buho29/wormgear/demo/README.en.md

<div align="center">

# ⚙️ WormGear demo

### A worm and its wheel to print, assemble and turn by hand

[Español](README.md) · **English** · [WormGear](../README.en.md)

Assembled demo

</div>

Printable demo of WormGear's default gear set: module 1.5, 30-tooth wheel, single-start Ø16 worm with a 35 mm thread, and 45° flanks. Turn the knob and the wheel makes one turn for every 30 turns of the worm. The gear set is generated by [WormGear](../README.en.md).

The worm and the wheel are each printed **in one piece with their shafts**, which turn in "bearings" made of two 45° cones. The caps slide down into the columns, guided by tongues.

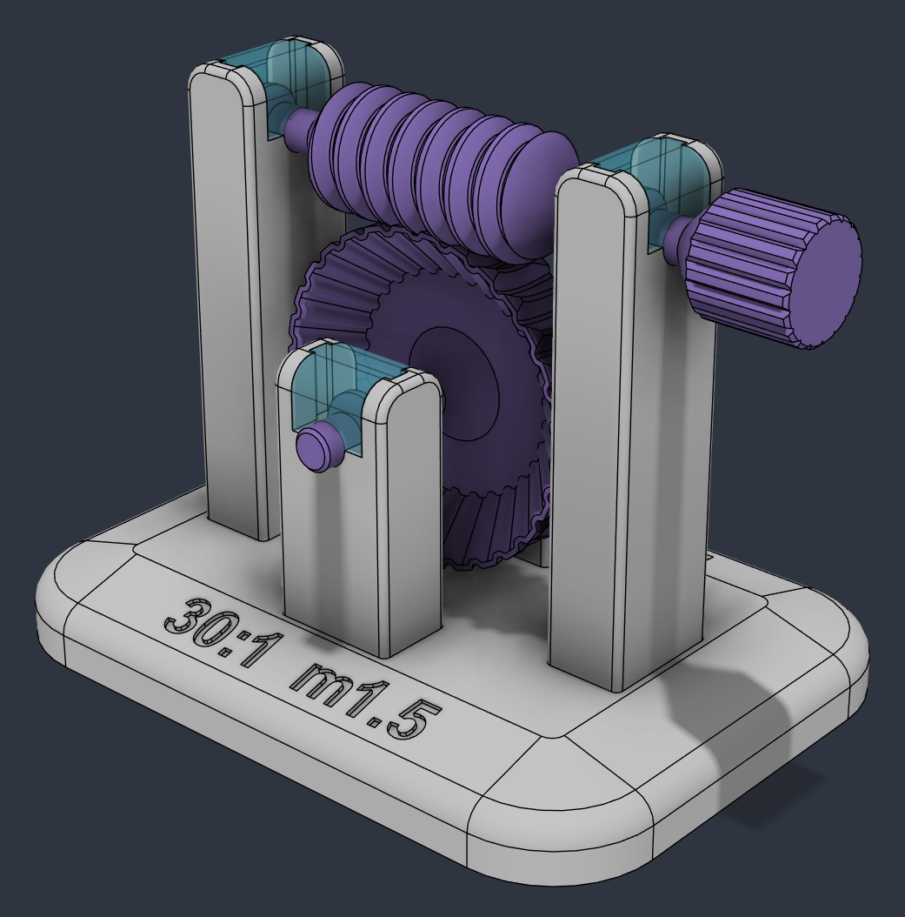
[picture p18: demo/img/conjunto_atras.png]
Rear view


## 📷 Printed

| | | |
|---|---|---|
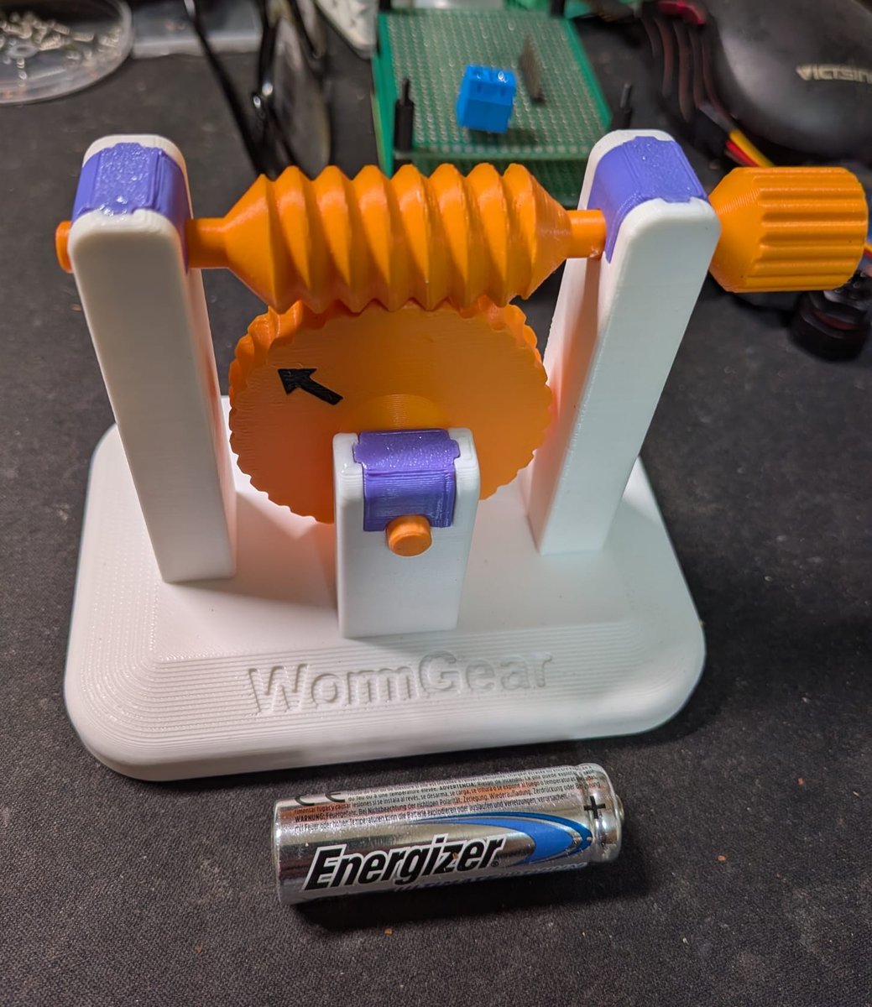
[picture p19: demo/img/impresa_frente.jpg]
Printed demo, front
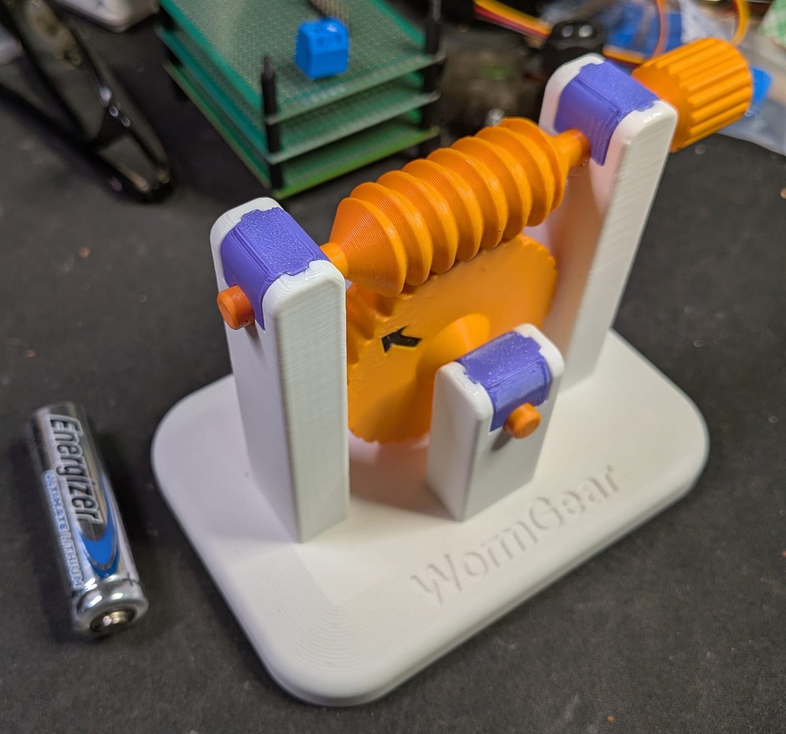
[picture p20: demo/img/impresa_lado.jpg]
Printed demo, side
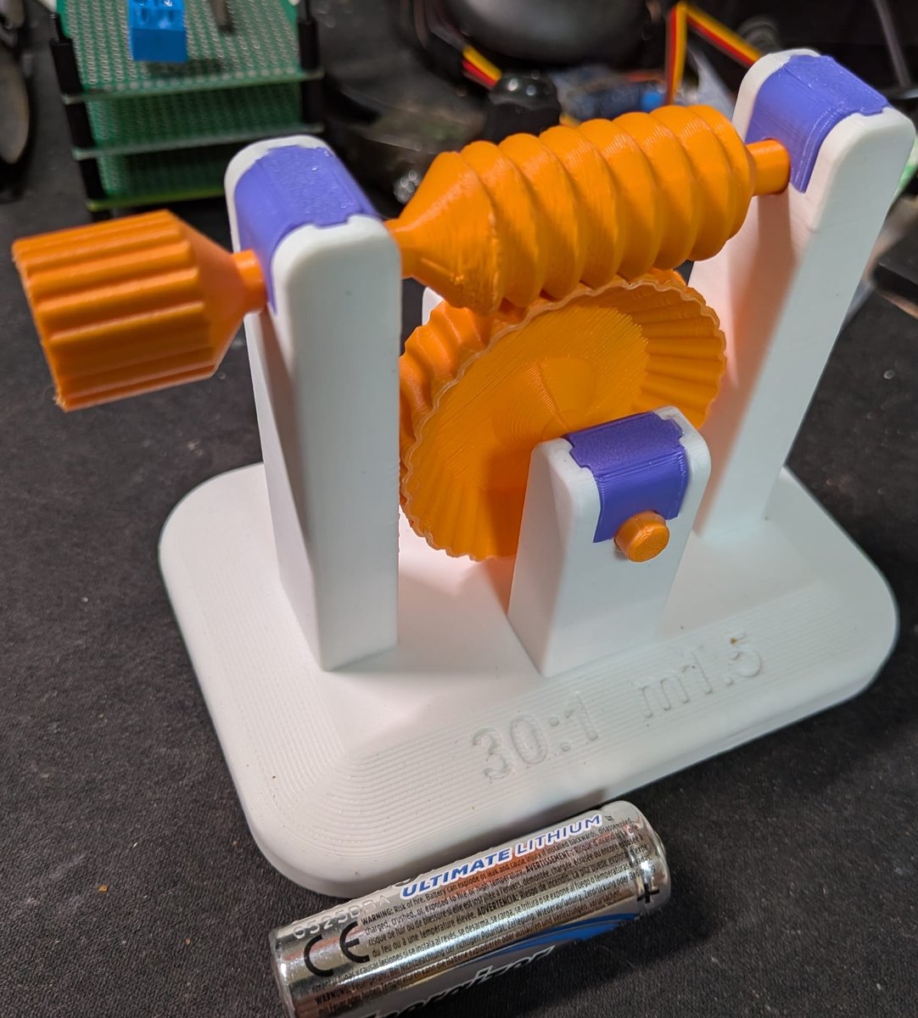
[picture p21: demo/img/impresa_relacion.jpg]
Printed demo, with the engraved ratio
|  |  |  |

## 🧩 Parts

The STEP files in [`3d files/`](3d%20files/) are already in their printing orientation, with the bed at z = 0. They need no slicer supports.

| File | Qty | How to print |
|---|---|---|
| [`base.step`](3d%20files/base.step) | 1 | Plate on the bed. |
| [`tapa.step`](3d%20files/tapa.step) (cap) | 4 | As mounted. The four caps are identical. |
| [`sinfin.step`](3d%20files/sinfin.step) (worm) | 1 | Standing, knob down. |
| [`rueda.step`](3d%20files/rueda.step) (wheel) | 1 | Standing on the tip of the shaft on the recessed side. The file holds the wheel and its support, already in place. To remove the support, hold the wheel and pull the support off with pliers, without putting force on the shaft. |

[`conjunto.step`](3d%20files/conjunto.step) is the assembled demo, without the support.

[`WormGear.3mf`](3d%20files/WormGear.3mf) is the Bambu Studio project with all the parts on a single plate. It is set up for a Bambu Lab P1S with a 0.4 nozzle, PLA and 0.2 mm layers. [`WormGear.f3d`](3d%20files/WormGear.f3d) is the Fusion design.

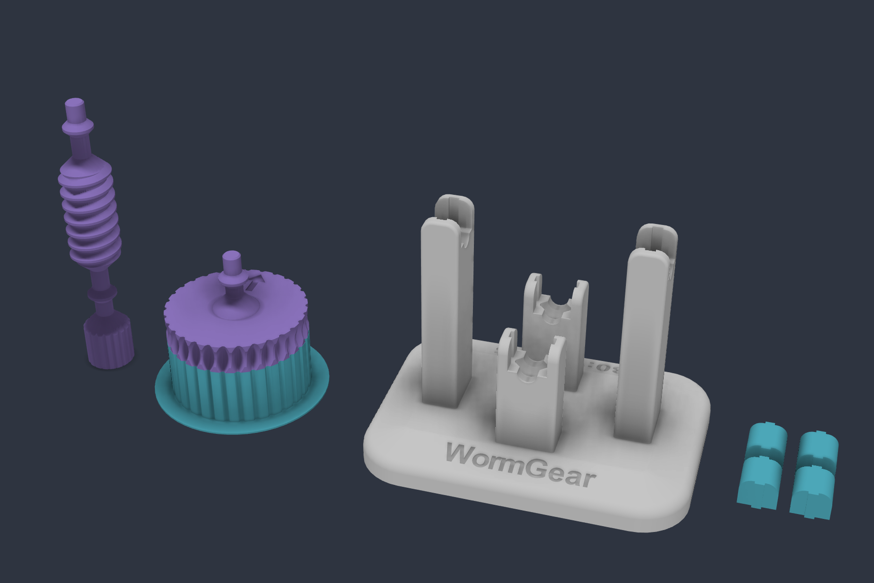
[picture p22: demo/img/piezas.png]
Parts in printing orientation


## 🛞 The wheel support

The wheel is printed standing on the tip of its lower shaft, so the wheel sits 20 mm above the bed. To hold it up:

- **Recess:** the lower face of the wheel has a recess that rises at 45°, 4 mm inwards. That way almost the whole face prints without bridges.
- **Ring:** outside the recess only a 0.8 mm ring is left, following the outline of the teeth.
- **Support:** it is that same ring extruded down to the bed, with a 6 mm flange on the bed. Its section is an L: the wall holds the ring and the flange acts as a brim, so the part does not move.

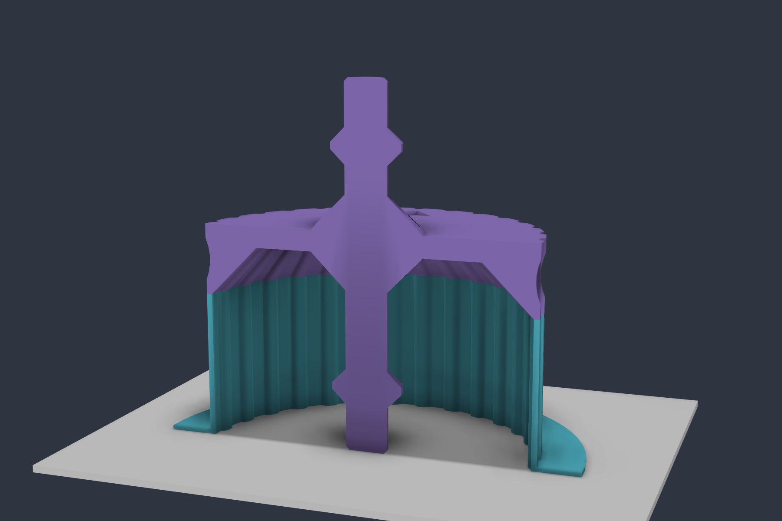
[picture p23: demo/img/soporte_seccion.png]
Section of the wheel with its support


## 🔧 Assembly

1. Rest the wheel and worm shafts in the half housings of the columns. The double cone of each shaft drops into its seat.
2. Slide each cap into its column from the top, with the tongues in the grooves, until it is all the way down, and fix it with a drop of glue (Loctite).

The mating parts have 0.1 mm of clearance per side.

- **Grease:** a little on the shaft "bearings" is recommended.
- **If a shaft drags:** if the shaft stops turning smoothly once the cap is down, lightly sand the outer diameter of the shaft's double cone.

## 🛠️ The Fusion script

[`fusion/WormGearDemo/`](fusion/WormGearDemo/) builds the whole demo in the active design. Run it from **Utilities › Add-Ins › Scripts**. It uses the `wormgear` package in [`../fusion`](../fusion/), so you need the whole repository.

- **Worm and wheel:** they come from WormGear.
- **Other parts:** the base, caps, shafts, recess, engravings and support are regular timeline features, so you can edit them afterwards.
- **Dimensions:** they are constants at the top of the script. The fillets are user parameters: `redondeo_placa`, `redondeo_chaflan`, `redondeo_columnas` and `redondeo_brazos`.
- **Assembly:** the script creates the joints and a motion link. Drag the worm and the wheel turns.

## 💡 Note

The trick of printing the wheel in one piece with its shaft comes from the video by **Iker Libano** ([KNIN Custom](https://www.youtube.com/@KNIN_Custom)) [*La Sorprendente Ingeniería Detrás de los Engranajes Impresos en 3D*](https://www.youtube.com/watch?v=5GPN3j80qZo&t=307s) (in Spanish).
