buho29/wormgear/demo/3d files/WormGear.3mf

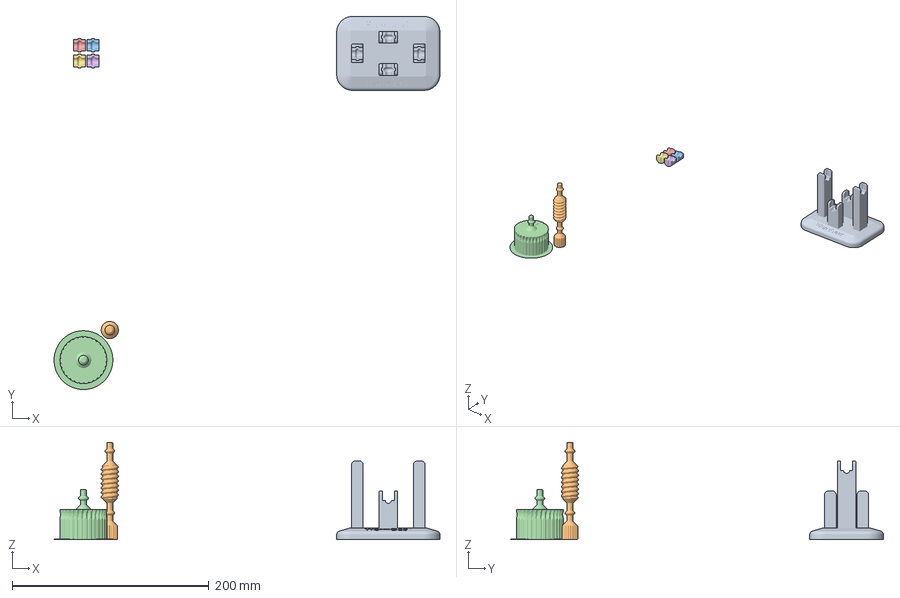
[picture p41: CAD file, 2026-11-08]
demo/3d files/WormGear.3mf
392.2 x 379.1 x 99.0 mm
base
sinfin
tapa x 4
rueda
