buho29/wormgear/demo/3d files/rueda.step

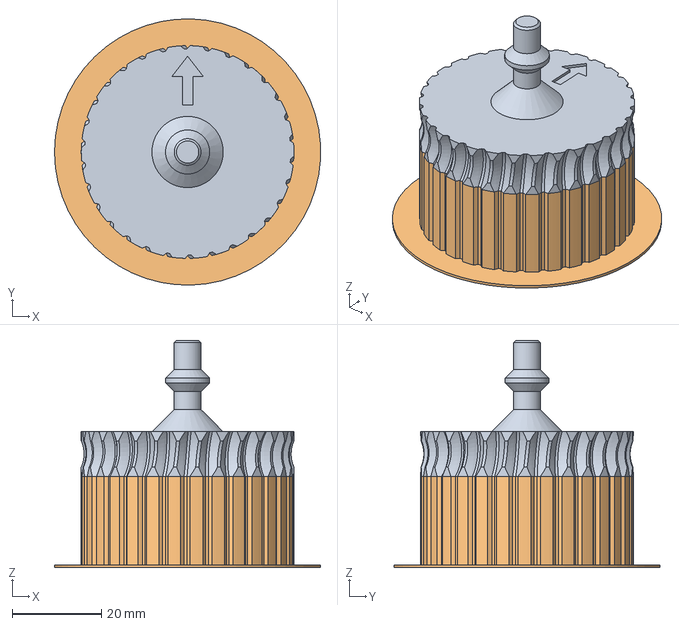
[picture p42: CAD file, 2026-11-08]
demo/3d files/rueda.step
59.7 x 59.7 x 51.0 mm
