buho29/wormgear/demo/3d files/sinfin.step

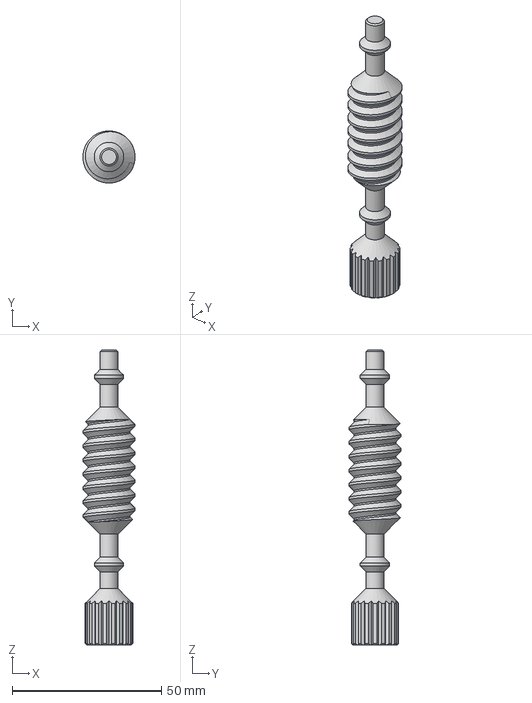
[picture p43: CAD file, 2026-11-08]
demo/3d files/sinfin.step
17.5 x 17.5 x 99.0 mm
