buho29/wormgear/demo/3d files/conjunto.step

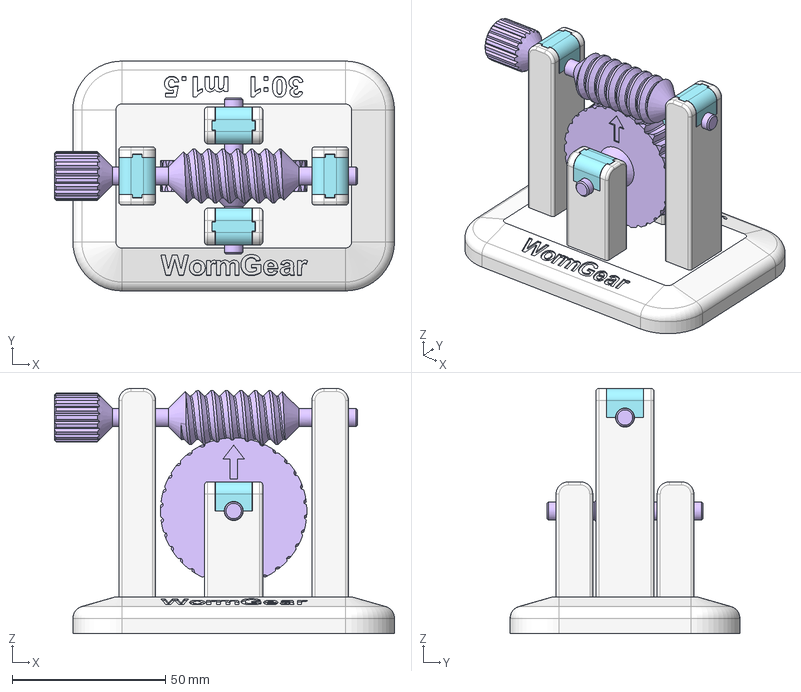
[picture p44: CAD file, 2026-11-08]
demo/3d files/conjunto.step
111.0 x 75.0 x 80.0 mm
Rueda m1.5 30:1
Sinfín m1.5 30:1
Base
Tapa x 4
Ejes m1.5 30:1
