buho29/wormgear/demo/3d files/base.step

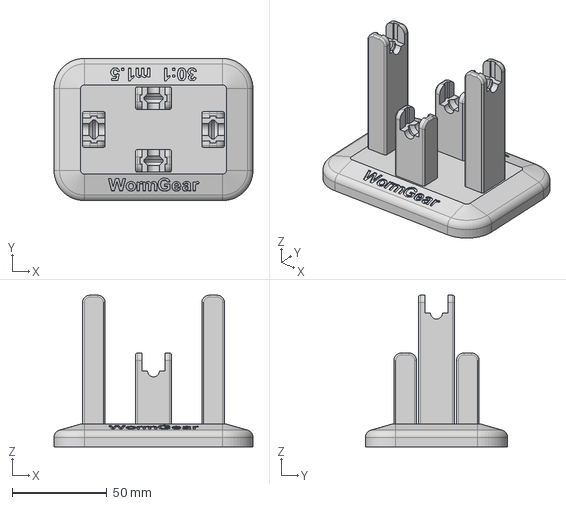
[picture p45: CAD file, 2026-11-06]
demo/3d files/base.step
105.0 x 75.0 x 80.0 mm
