buho29/wormgear/demo/3d files/tapa.step

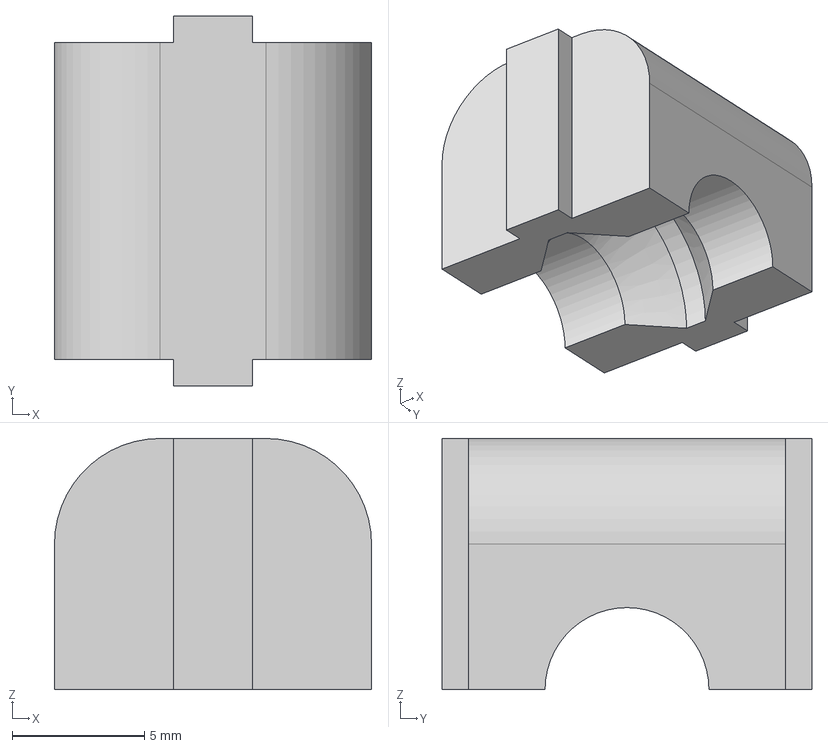
[picture p46: CAD file, 2026-11-06]
demo/3d files/tapa.step
12.0 x 14.0 x 9.50 mm
