buho29/wormgear/(list of files, cad)

Other CAD files:
demo/3d files/WormGear.f3d
