buho29/wormgear/(commit log)

2026-10-30 Add-in WormGear de Fusion para generar sinfín y rueda paramétricos
    Rueda lisa a partir de perfiles de envolvente por plano y solevación, chaflán
    de 45° automático en las caras, juntas de giro con enlace de movimiento en
    diseños de ensamblaje e híbridos y comprobación opcional de interferencias y
    juego. Se instala con un enlace desde la carpeta AddIns (install.ps1).
2026-10-30 Instalador en zip del add-in WormGear (instalar.bat / desinstalar.bat)
    make_release.ps1 genera dist/WormGear-<versión>.zip con la carpeta del add-in,
    un LEEME.txt y dos .bat que copian o quitan el add-in de la carpeta AddIns de
    Fusion sin pedir administrador, conservan settings.json al actualizar y no
    tocan una instalación de desarrollo enlazada al repo.
2026-10-30 Diagramas de cómo se calcula la rueda del add-in WormGear (planos, cremallera, envolvente, normal por el primitivo y perfiles)
2026-10-30 De dónde sale el método de la rueda del add-in WormGear, con referencias comprobadas
2026-10-31 Versión para FreeCAD: banco de trabajo paramétrico "Sinfín y rueda" con la misma matemática que el add-in de Fusion
2026-10-31 Repo propio: README de portada, licencia MIT, package.xml para el gestor de complementos de FreeCAD y rutas nuevas
2026-10-31 README de portada con lo común a las dos versiones (parámetros, comprobación y cálculo de la rueda) e insignias; los diagramas pasan a img/ de la raíz
2026-10-31 Imagen del primer intento de la rueda (mecanizada con restas) frente a la solevación en el README
2026-10-31 Sinfín a izquierdas, taladros con plano en D, hexagonales, cuadrados y con chavetero DIN 6885, y tramos lisos en el sinfín (Fusion y FreeCAD, versión 1.1.0)
    - geometry.py: a izquierdas es el simétrico respecto a x = 0 (gap_profile sale espejado);
    silueta del sinfín (worm_outline) con chaflanes y tramos lisos; contornos de taladro (bore_outline)
    y sus comprobaciones.
    - Fusion: taladros como boceto + extrusión de corte editables; enlace de movimiento invertido
    a izquierdas; campos nuevos en el diálogo.
    - FreeCAD: propiedades nuevas (se añaden al abrir documentos de la versión anterior); prisma del
    taladro; espejo del sinfín.
    - Comprobación con el giro de la rueda al revés a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
2026-10-31 Capturas nuevas del banco de FreeCAD y del diálogo de Fusion, con las opciones de la 1.1.0
2026-10-31 install.ps1 registra el add-in con la ruta del repo en vez de enlazarlo en AddIns: Fusion seguía el enlace y lo cargaba dos veces
2026-10-31 GIF nuevo del engrane (30:1, con el suelo abajo) para la portada y el README de Fusion
2026-10-31 GIF del engrane con la rueda de pie sobre el suelo, bordes visibles y sombra quieta
2026-10-31 Rendimiento estimado y autobloqueo con el ángulo de presión normal, comparativa con otros generadores y GIF del corte por el plano medio
    - geometry.py: efficiency() y locking_limit_deg(); el resumen da el rendimiento con grasa (μ 0.1) y en seco (μ 0.3) y el autobloqueo con tan λ ≤ μ / cos αn, en vez de la regla fija de 5.5°.
    - comparativa.md: qué hacen GearWorkBench, freecad.gears, Helical Gear+, Worm Gear FS (Onshape), Inventor y BOSL2, con fuentes.
    - fusion/img/seccion.gif en el paso 2 de "Cómo se calcula".
2026-10-31 Interfaz en inglés si Fusion o FreeCAD no están en castellano, y README en inglés
    - wormgear/i18n.py (igual en las dos versiones): tr() con los textos en castellano como clave y su
    traducción; problems() comprueba que no falta ninguna y que los % coinciden (también en run_tests.py).
    - Fusion elige el idioma con generalPreferences.userLanguage; FreeCAD, con el de sus preferencias o
    el del sistema (al arrancar, FreeCADGui aún no tiene getLocale).
    - FreeCAD: los documentos guardados en otro idioma se adaptan al abrirlos (grupos, descripciones y
    lista de taladros), sin recalcular.
    - README.en.md, fusion/README.en.md, freecad/README.en.md y comparativa.en.md; el zip lleva README.txt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
2026-10-31 Captura de la solevación de un hueco en Fusion, en el paso 5 de la portada y en el README de Fusion (castellano e inglés)
2026-10-31 FreeCAD: perfiles del hueco con los mismos nudos, para que el corte de la rueda no se coma la memoria
    Con 20° de flanco y diente normal, cada perfil de la solevación tenía nudos distintos y OCCT los juntaba:
    caras de 4423 polos, y el corte de los 30 huecos pasaba de 6 GB en segundos y colgaba el equipo.
    Con parámetros uniformes salen 203 polos y la rueda se genera en 35 s. Con los valores por defecto
    la rueda sale igual (mismo volumen) y las cuatro pruebas pasan con los mismos resultados.
2026-11-01 Comparativa: prueba a 30° de GearWorkBench y WormGear con el mismo montaje, con el porqué de los piquitos de las puntas (castellano e inglés)
2026-11-01 Rueda: el pie del diente sigue la trocoide de la cabeza del sinfín; con 20° y diente normal ya no roza (0 mm³, juego 0.100 mm)
    Con poco ángulo de flanco la envolvente no bajaba hasta el fondo y el hueco se cerraba con un arco que no dejaba paso
    a la esquina de la cresta. Ahora, a cada radio, el flanco es el de la envolvente o el de la trocoide que más entra en el diente.
    Prueba de 20° con diente normal en run_tests.py; comparativa con GearWorkBench también a 20°.
    Probado en FreeCAD (5 juegos) y en Fusion (6 juegos): 0 mm³ y juego de 0.099 a 0.104 mm.
2026-11-01 Portada y comparativa: la rueda de un solo corte y el helicoidal con garganta frente a WormGear, a 20° (castellano e inglés)
2026-11-01 Comparativa: GearWorkBench a 30° medido otra vez con cortes 2D (de 0.9 a 1.0 mm³; el booleano 3D fallaba en una posición)
2026-11-02 Portada: qué ángulo de flanco elegir (rendimiento, fuerza radial y autobloqueo a 20°, 30° y 45°; 30° para PLA/PETG y 45° para ABS/ASA). El aviso de voladizo mide desde la horizontal, como el laminador
2026-11-02 Portada: cuándo conviene más rendimiento y cuándo el autobloqueo
2026-11-03 Demo imprimible: base con columnas, tapas con pasador de filamento, sinfín y rueda de una pieza con sus ejes, soporte de la rueda, STEP de cada pieza y del conjunto, renders y README. En la portada, 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
    [base.step, conjunto.step, rueda.step, sinfin.step, soporte_rueda.step, tapa.step]
2026-11-03 Demo: renders del conjunto nuevos, los STEP pasan a "3d files" con el 3MF de la base, el diseño de Fusion (.f3d) y .gitignore para la caché de Python. Historia de la portada retocada
    [WormGear.3mf, WormGear.f3d, base.step, conjunto.step, rueda.step, sinfin.step, soporte_rueda.step, tapa.step]
2026-11-04 Diálogo de Fusion: tamaño inicial para que no se salga de la pantalla la primera vez y Resumen a todo el ancho
2026-11-04 Rueda en Fusion: si el boceto de una sección no da un solo perfil, se repite con otro número de puntos
    En los extremos, la esquina del pie del diente podía dejar el boceto con 2 perfiles según por dónde cayeran los puntos de la spline (Ø20 con ancho 12, Ø24 con ancho 14, 16 y 20). Probado en Fusion en un diseño de pieza con 4 juegos: 0 mm³ y juego de 0.100 mm.
2026-11-04 Resumen del diálogo: una línea corta por dato con la etiqueta en negrita (también en el Summary de FreeCAD), README de Fusion al día y captura nueva
2026-11-04 Rueda: el pie del diente usa las dos ramas de la trocoide y desaparece el escalón que rompía los perfiles en los extremos; fuera el reintento de build.py
    A cada radio, la trocoide de la cabeza del sinfín tiene dos puntos y vale el que más entra en el diente. El código cogía siempre el del mismo lado, y en los extremos de la rueda, con el fondo por encima del radio primitivo, era el otro. Con 198 configuraciones, en Fusion (4 secciones de un extremo) salen 196 a la primera, antes 171, y en FreeCAD (solevación) 196, antes 167. Los otros 2 tienen el hueco casi en punta y ya fallaban antes de la trocoide.
    run_tests.py en FreeCAD: 5 juegos, 0 mm³ y juego de 0.100 a 0.104 mm. En Fusion, 12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
2026-11-04 Ventana de progreso al generar en Fusion, y el sinfín tarda mucho menos: el filete solo se dibuja donde hay filete
    - Ventana con texto por etapa y avance por perfil y por fase, sin doEvents y sin botón de cancelar. Se cierra siempre, también con error, y antes de cualquier mensaje. build y check solo reciben un on_step opcional.
    - Con el valor 0 la ventana no salía hasta el siguiente aviso, y con un solo valor salía en blanco: el primer aviso manda dos valores.
    - Hélices del filete de 2·thread_half + 2·lead en vez de toda la longitud: de 14 s a 3 s cada una con 40 mm de filete en 70 mm, con la misma pieza. Sin efecto si todo el sinfín lleva filete.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
2026-11-04 Demo: los README citan el proyecto de Bambu Studio (WormGear.3mf) y el diseño de Fusion (WormGear.f3d)
2026-11-06 Demo: tapas y columnas 3 mm más bajas, sin pasador de filamento, y rebaje de la rueda 3 mm más hondo
    El script, los STEP, las imágenes y los README pasan a la versión nueva. WormGear.3mf y WormGear.f3d siguen con el diseño anterior.
    [base.step, conjunto.step, rueda.step, sinfin.step, soporte_rueda.step, tapa.step]
2026-11-08 Demo: rodamientos de los ejes a Ø 9,9 (0,1 menos) y la rueda con su soporte en un solo STEP
    [conjunto.step, rueda.step, sinfin.step, soporte_rueda.step]
2026-11-08 Demo: proyecto de Bambu Studio (WormGear.3mf) al día
    [WormGear.3mf]
2026-11-08 Demo: diseño de Fusion (WormGear.f3d) al día
    [WormGear.f3d]
2026-11-08 Demo: fotos de la demo impresa y consejos de montaje (soporte, pegamento, grasa, lijado) en los README
